achkoe/pt1000thermometer/Readme.md

See doc/pt1000thermometer.pdf for some description of this project.
