achkoe/pt1000thermometer/doc/pt1000thermometer.pdf

## Thermometer with PT1000

# ~{RESET} 28 ~{RESET}3 VIN ³⁰ GND

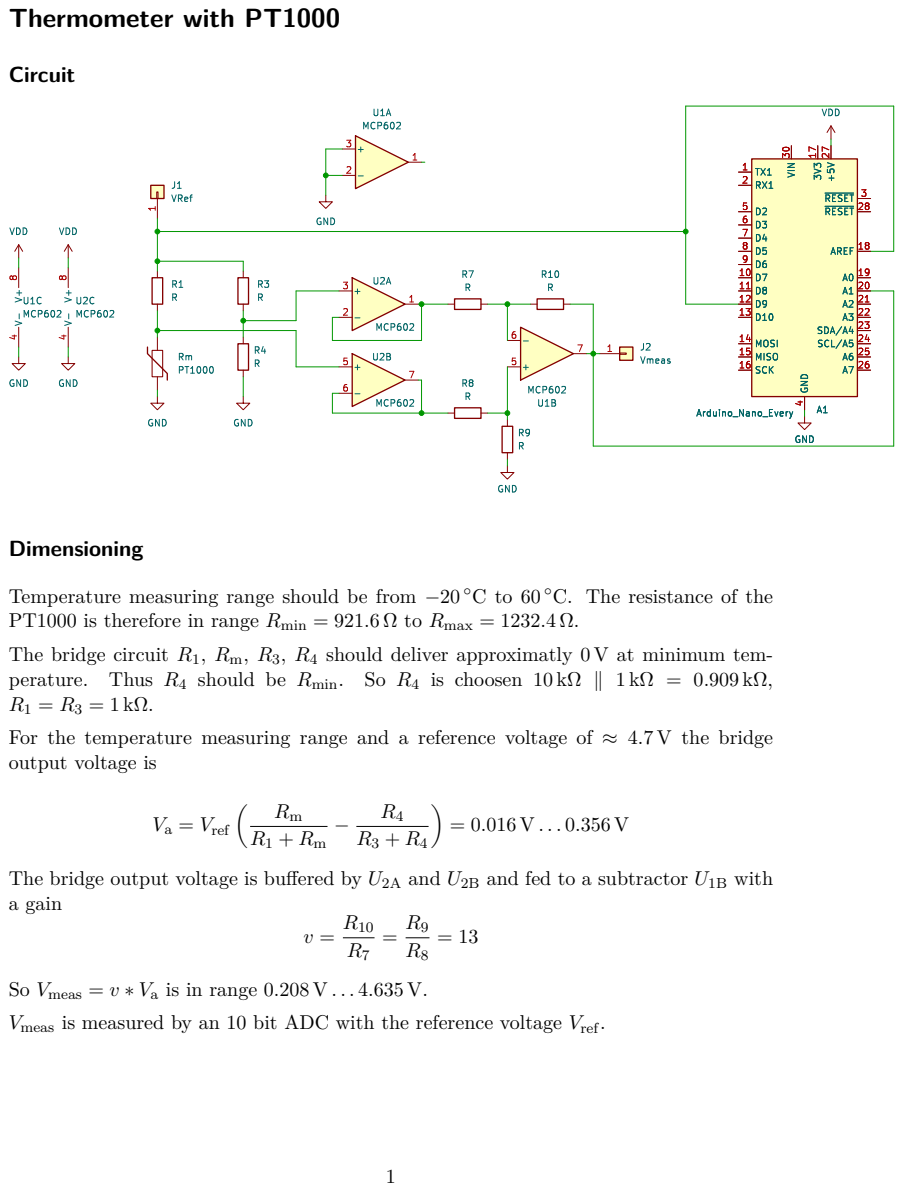
[picture p1: page 1]

Temperature measuring range should be from −20 ◦C to 60 ◦C. The resistance of the
PT1000 is therefore in range Rmin = 921.6 Ω to Rmax = 1232.4 Ω.
The bridge circuit R1, Rm, R3, R4 should deliver approximatly 0 V at minimum tem-
perature. Thus R4 should be Rmin. So R4 is choosen 10 kΩ ∥ 1 kΩ = 0.909 kΩ,
For the temperature measuring range and a reference voltage of ≈ 4.7 V the bridge
output voltage is

The bridge output voltage is buffered by U2A and U2B and fed to a subtractor U1B with
a gain

So Vmeas = v ∗ Va is in range 0.208 V . . . 4.635 V.
Vmeas is measured by an 10 bit ADC with the reference voltage Vref.

Relationship of temperature and ADC value

In the temperature measuring range the value of PT1000 resistor could be approximated
[1] by

Rm = R0(1 + AT + BT²
)

with R0 = 1000 Ω, A = 3.9083 · 10−3 1 ◦C

and B = −5.7750 · 10−7 1
◦C² within the accuracy
of the ADC.
Vice versa the temperature could be calculated with

T1,2 = −

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
The value of PT1000 resistor is calculated

Va =

Vmeas
v

+ Vref

R4
R3 + R4

Rm = R1

Va

Vref − Va

The Vmeas could be determined from ADC value D by

Vmeas =

DVref
2

10

Simplification

Vmeas = D

Vref
1024

(1)

Va =

Vmeas
v
+ kVref | with | k =

R4
R3 + R4

(2)

= D

Vref
1024v
+ kVref | (3)
Rm | = R1

Va

Vref − Va

(4)

= R1

D

Vref
1024v + kVref

Vref −

(
D

Vref

1024v + kVref) = R1

D
1024v + k

1 −

(
D
1024v + k
) | (5)

= R1

D + 1024vk
1024v (1 − k) − D

(6)

Note, the value of Rm does not depend on Vref!

2

Measuring

The measurement of the temperature is done as follows
- drive the output D9, which actually supplies Vref, to high
- wait 10 ms
- measure voltage
- drive the output to low
- wait 2 s to let the PT1000 cool down

## References

[1] Application Note, A Basic Guide to RTD Measurements. https://www.ti.com/lit/an/sbaa275a/sbaa275a.pdf. Retrieved 2024-01-07

3
