achkoe/pt1000thermometer/doc/pt1000thermometer.tex

\documentclass[fontsize=11pt, oneside]{scrartcl}
%\usepackage[textwidth=10cm, lmargin=4cm, rmargin=3cm ]{geometry}
\usepackage{hyperref}
\hypersetup{colorlinks, linkcolor=black, citecolor=blue, urlcolor=black}
\usepackage[utf8]{inputenc}
\usepackage[english]{babel}
\usepackage{siunitx}
\usepackage{graphicx}
\usepackage{supertabular}
\graphicspath{{../schematics/}}

\parindent0pt
\parskip1ex

\newcommand{\F}[2]{{#1}_\mathrm{#2}}

\begin{document}

\section*{Thermometer with PT1000}

\subsection*{Circuit}


\subsection*{Dimensioning}

Temperature measuring range should be from $\qty{-20}{\degreeCelsius}$ to $\qty{+60}{\degreeCelsius}$.
The resistance of the PT1000 is therefore in range
$\F{R}{min} = \qty{921.6}{\ohm}$ to $\F{R}{max} = \qty{1232.4}{\ohm}$.

The bridge circuit $\F{R}{1}$, $\F{R}{m}$, $\F{R}{3}$, $\F{R}{4}$ should deliver approximatly $\qty{0}{\volt}$ at minimum
temperature. Thus $\F{R}{4}$ should be $\F{R}{min}$.
So $\F{R}{4}$ is choosen $\qty{10}{k\ohm} \parallel \qty{1}{k\ohm} = \qty{0.909}{k\ohm}$,
$\F{R}{1} = \F{R}{3} = \qty{1}{k\ohm}$.

For the temperature measuring range
and a reference voltage of $\approx\qty{4.7}{\volt}$
the bridge output voltage is

$$
\F{V}{a} = \F{V}{ref} \left( \frac{\F{R}{m}}{\F{R}{1} + \F{R}{m}} - \frac{\F{R}{4}}{\F{R}{3} + \F{R}{4}}\right) = \qty{0.016}{\volt} \ldots \qty{0.356}{\volt}
$$
%    Um = Ue * Rm / (R1 + Rm)
%    U4 = Ue * R4 / (R3 + R4)
%    Ua = V * (Um - U4)

The bridge output voltage is buffered by $\F{U}{2A}$ and $\F{U}{2B}$ and fed to a subtractor $\F{U}{1B}$
with a gain
$$
v = \frac{\F{R}{10}} {\F{R}{7}} = \frac{\F{R}{9}} {\F{R}{8}} = 13
$$

So $\F{V}{meas} = v * \F{V}{a}$ is in range $\qty{0.208}{\volt} \ldots \qty{4.635}{\volt}$.

$\F{V}{meas}$ is measured by an 10 bit ADC with the reference voltage $\F{V}{ref}$.

\subsection*{Relationship of temperature and ADC value}

In the temperature measuring range the value of PT1000 resistor could be approximated
\cite{la} by

$$
\F{R}{m} = \F{R}{0} (1 + A T + B T^2)
$$

with $\F{R}{0} = \qty{1000}{\ohm}, $ $A=3.9083\cdot 10^{-3}\frac{1}{\unit{\degreeCelsius}}$ and $B=-5.7750\cdot10^{-7}\frac{1}{\unit{\degreeCelsius}^2}$
within the accuracy of the ADC.

Vice versa the temperature could be calculated with

$$
\F{T}{1,2} = -\frac{A}{2B} \sqrt{\left(\frac{A}{2B}\right)^2 - \frac{1}{B}\left(1 - \frac{\F{R}{m}}{\F{R}{0}} \right)}
$$

The value of PT1000 resistor is calculated
$$
\F{V}{a} = \frac{\F{V}{meas}}{v} + \F{V}{ref} \frac{\F{R}{4}}{\F{R}{3} + \F{R}{4}}
$$
$$
\F{R}{m} = \F{R}{1} \frac{\F{V}{a}}{\F{V}{ref} - \F{V}{a}}
$$

The $\F{V}{meas}$ could be determined from ADC value $D$ by
$$
\F{V}{meas} = \frac{D \F{V}{ref}}{2^{10}}
$$

\subsection*{Simplification}
\begin{eqnarray}
    \F{V}{meas} &=& D \frac{\F{V}{ref}}{1024} \\
    \F{V}{a} &=& \frac{\F{V}{meas}}{v} + k\F{V}{ref} \qquad \mbox{with} \qquad k = \frac{\F{R}{4}}{\F{R}{3} + \F{R}{4}} \\
             &=& D \frac{\F{V}{ref}}{1024 v} + k\F{V}{ref} \\
    \F{R}{m} &=& \F{R}{1} \frac{\F{V}{a}} {\F{V}{ref} - \F{V}{a}} \\
             &=& \F{R}{1} \frac{D \frac{\F{V}{ref}}{1024 v} + k\F{V}{ref}}{\F{V}{ref} - \left(D \frac{\F{V}{ref}}{1024 v} + k\F{V}{ref}\right)} %
              =  \F{R}{1} \frac{\frac{D}{1024 v} + k}{1 - \left(\frac{D}{1024 v} + k\right)} \\
             &=&  \F{R}{1} \frac{D + 1024vk}{1024v\left(1-k\right) - D}
\end{eqnarray}
Note, the value of $\F{R}{m}$ does not depend on $\F{V}{ref}$!
        %Vmeas = value * Vref / 1024;
        %Va = Vmeas / v + Vref * R4 / (R3 + R4);

\subsection*{Measuring}

The measurement of the temperature is done as follows
\begin{itemize}
\item drive the output D9, which actually supplies $\F{V}{ref}$, to high
\item wait $\qty{10}{\milli\second}$
\item measure voltage
\item drive the output to low
\item wait $\qty{2}{\second}$ to let the PT1000 cool down
\end{itemize}

\begin{thebibliography}{}
\bibitem{la} Application Note, A Basic Guide to RTD Measurements. \\
https://www.ti.com/lit/an/sbaa275a/sbaa275a.pdf. Retrieved 2024-01-07
\end{thebibliography}

\end{document}

\clearpage

\subsection*{Appendix}

\tablecaption{ADC value and temperature}
\tablehead{\hline}
\tabletail{\hline}
% \begin{supertabular}{llllllllllllllll}
\begin{supertabular}{lrrrrrrrr}
D                         &      0 &      1 &      2 &      3 &      4 &      5 &      6 &      7 \\
T/$\unit{\degreeCelsius}$ & -23.18 & -23.11 & -23.04 & -22.97 & -22.90 & -22.83 & -22.76 & -22.69 \\
D                         &      8 &      9 &     10 &     11 &     12 &     13 &     14 &     15 \\
T/$\unit{\degreeCelsius}$ & -22.62 & -22.55 & -22.48 & -22.41 & -22.34 & -22.27 & -22.20 & -22.14 \\
D                         &     16 &     17 &     18 &     19 &     20 &     21 &     22 &     23 \\
T/$\unit{\degreeCelsius}$ & -22.07 & -22.00 & -21.93 & -21.86 & -21.79 & -21.72 & -21.65 & -21.58 \\
D                         &     24 &     25 &     26 &     27 &     28 &     29 &     30 &     31 \\
T/$\unit{\degreeCelsius}$ & -21.51 & -21.44 & -21.36 & -21.29 & -21.22 & -21.15 & -21.08 & -21.01 \\
D                         &     32 &     33 &     34 &     35 &     36 &     37 &     38 &     39 \\
T/$\unit{\degreeCelsius}$ & -20.94 & -20.87 & -20.80 & -20.73 & -20.66 & -20.59 & -20.52 & -20.45 \\
D                         &     40 &     41 &     42 &     43 &     44 &     45 &     46 &     47 \\
T/$\unit{\degreeCelsius}$ & -20.38 & -20.31 & -20.24 & -20.17 & -20.10 & -20.03 & -19.96 & -19.89 \\
D                         &     48 &     49 &     50 &     51 &     52 &     53 &     54 &     55 \\
T/$\unit{\degreeCelsius}$ & -19.82 & -19.75 & -19.68 & -19.60 & -19.53 & -19.46 & -19.39 & -19.32 \\
D                         &     56 &     57 &     58 &     59 &     60 &     61 &     62 &     63 \\
T/$\unit{\degreeCelsius}$ & -19.25 & -19.18 & -19.11 & -19.04 & -18.97 & -18.90 & -18.83 & -18.76 \\
D                         &     64 &     65 &     66 &     67 &     68 &     69 &     70 &     71 \\
T/$\unit{\degreeCelsius}$ & -18.68 & -18.61 & -18.54 & -18.47 & -18.40 & -18.33 & -18.26 & -18.19 \\
D                         &     72 &     73 &     74 &     75 &     76 &     77 &     78 &     79 \\
T/$\unit{\degreeCelsius}$ & -18.12 & -18.04 & -17.97 & -17.90 & -17.83 & -17.76 & -17.69 & -17.62 \\
D                         &     80 &     81 &     82 &     83 &     84 &     85 &     86 &     87 \\
T/$\unit{\degreeCelsius}$ & -17.55 & -17.47 & -17.40 & -17.33 & -17.26 & -17.19 & -17.12 & -17.05 \\
D                         &     88 &     89 &     90 &     91 &     92 &     93 &     94 &     95 \\
T/$\unit{\degreeCelsius}$ & -16.97 & -16.90 & -16.83 & -16.76 & -16.69 & -16.62 & -16.55 & -16.47 \\
D                         &     96 &     97 &     98 &     99 &    100 &    101 &    102 &    103 \\
T/$\unit{\degreeCelsius}$ & -16.40 & -16.33 & -16.26 & -16.19 & -16.11 & -16.04 & -15.97 & -15.90 \\
D                         &    104 &    105 &    106 &    107 &    108 &    109 &    110 &    111 \\
T/$\unit{\degreeCelsius}$ & -15.83 & -15.76 & -15.68 & -15.61 & -15.54 & -15.47 & -15.40 & -15.32 \\
D                         &    112 &    113 &    114 &    115 &    116 &    117 &    118 &    119 \\
T/$\unit{\degreeCelsius}$ & -15.25 & -15.18 & -15.11 & -15.04 & -14.96 & -14.89 & -14.82 & -14.75 \\
D                         &    120 &    121 &    122 &    123 &    124 &    125 &    126 &    127 \\
T/$\unit{\degreeCelsius}$ & -14.68 & -14.60 & -14.53 & -14.46 & -14.39 & -14.31 & -14.24 & -14.17 \\
D                         &    128 &    129 &    130 &    131 &    132 &    133 &    134 &    135 \\
T/$\unit{\degreeCelsius}$ & -14.10 & -14.02 & -13.95 & -13.88 & -13.81 & -13.73 & -13.66 & -13.59 \\
D                         &    136 &    137 &    138 &    139 &    140 &    141 &    142 &    143 \\
T/$\unit{\degreeCelsius}$ & -13.52 & -13.44 & -13.37 & -13.30 & -13.23 & -13.15 & -13.08 & -13.01 \\
D                         &    144 &    145 &    146 &    147 &    148 &    149 &    150 &    151 \\
T/$\unit{\degreeCelsius}$ & -12.94 & -12.86 & -12.79 & -12.72 & -12.64 & -12.57 & -12.50 & -12.43 \\
D                         &    152 &    153 &    154 &    155 &    156 &    157 &    158 &    159 \\
T/$\unit{\degreeCelsius}$ & -12.35 & -12.28 & -12.21 & -12.13 & -12.06 & -11.99 & -11.91 & -11.84 \\
D                         &    160 &    161 &    162 &    163 &    164 &    165 &    166 &    167 \\
T/$\unit{\degreeCelsius}$ & -11.77 & -11.70 & -11.62 & -11.55 & -11.48 & -11.40 & -11.33 & -11.26 \\
D                         &    168 &    169 &    170 &    171 &    172 &    173 &    174 &    175 \\
T/$\unit{\degreeCelsius}$ & -11.18 & -11.11 & -11.04 & -10.96 & -10.89 & -10.82 & -10.74 & -10.67 \\
D                         &    176 &    177 &    178 &    179 &    180 &    181 &    182 &    183 \\
T/$\unit{\degreeCelsius}$ & -10.60 & -10.52 & -10.45 & -10.37 & -10.30 & -10.23 & -10.15 & -10.08 \\
D                         &    184 &    185 &    186 &    187 &    188 &    189 &    190 &    191 \\
T/$\unit{\degreeCelsius}$ & -10.01 &  -9.93 &  -9.86 &  -9.79 &  -9.71 &  -9.64 &  -9.56 &  -9.49 \\
D                         &    192 &    193 &    194 &    195 &    196 &    197 &    198 &    199 \\
T/$\unit{\degreeCelsius}$ &  -9.42 &  -9.34 &  -9.27 &  -9.19 &  -9.12 &  -9.05 &  -8.97 &  -8.90 \\
D                         &    200 &    201 &    202 &    203 &    204 &    205 &    206 &    207 \\
T/$\unit{\degreeCelsius}$ &  -8.82 &  -8.75 &  -8.68 &  -8.60 &  -8.53 &  -8.45 &  -8.38 &  -8.31 \\
D                         &    208 &    209 &    210 &    211 &    212 &    213 &    214 &    215 \\
T/$\unit{\degreeCelsius}$ &  -8.23 &  -8.16 &  -8.08 &  -8.01 &  -7.93 &  -7.86 &  -7.79 &  -7.71 \\
D                         &    216 &    217 &    218 &    219 &    220 &    221 &    222 &    223 \\
T/$\unit{\degreeCelsius}$ &  -7.64 &  -7.56 &  -7.49 &  -7.41 &  -7.34 &  -7.26 &  -7.19 &  -7.12 \\
D                         &    224 &    225 &    226 &    227 &    228 &    229 &    230 &    231 \\
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
D                         &    976 &    977 &    978 &    979 &    980 &    981 &    982 &    983 \\
T/$\unit{\degreeCelsius}$ &  56.71 &  56.81 &  56.91 &  57.00 &  57.10 &  57.20 &  57.29 &  57.39 \\
D                         &    984 &    985 &    986 &    987 &    988 &    989 &    990 &    991 \\
T/$\unit{\degreeCelsius}$ &  57.48 &  57.58 &  57.68 &  57.77 &  57.87 &  57.97 &  58.07 &  58.16 \\
D                         &    992 &    993 &    994 &    995 &    996 &    997 &    998 &    999 \\
T/$\unit{\degreeCelsius}$ &  58.26 &  58.36 &  58.45 &  58.55 &  58.65 &  58.74 &  58.84 &  58.94 \\
D                         &   1000 &   1001 &   1002 &   1003 &   1004 &   1005 &   1006 &   1007 \\
T/$\unit{\degreeCelsius}$ &  59.03 &  59.13 &  59.23 &  59.33 &  59.42 &  59.52 &  59.62 &  59.72 \\
D                         &   1008 &   1009 &   1010 &   1011 &   1012 &   1013 &   1014 &   1015 \\
T/$\unit{\degreeCelsius}$ &  59.81 &  59.91 &  60.01 &  60.11 &  60.20 &  60.30 &  60.40 &  60.50 \\
D                         &   1016 &   1017 &   1018 &   1019 &   1020 &   1021 &   1022 &   1023 \\
T/$\unit{\degreeCelsius}$ &  60.59 &  60.69 &  60.79 &  60.89 &  60.99 &  61.08 &  61.18 &  61.28 \\
\end{supertabular}

Vmeas = D * Vref / 1024
Rm = R1 * Va / (Vref - Va)
Va = Vmeas / v + Vref * k = D * Vref / (v * 1024) + Vref * k = Vref * (D / (v * 1024) + k)
k = R4 / (R3 + R4) = 10 || 1 / (10 || 1 + 1) 
R4 = 0.9090909090909091 kOhm
k = 0.47619047619047616

Rm = R1 * Vref * (D / (v * 1024) + k) / (Vref - Vref * (D / (v * 1024) + k))
   = Vref * R1 * (D / (v * 1024) + k) / (Vref * (1 - (D / (v * 1024) + k)))
   = R1 * x / (1 - x) mit x = D / (v * 1024) + k
   = R1 / (1 / x - 1)
