achkoe/pt1000thermometer/schematics/schematics.pdf

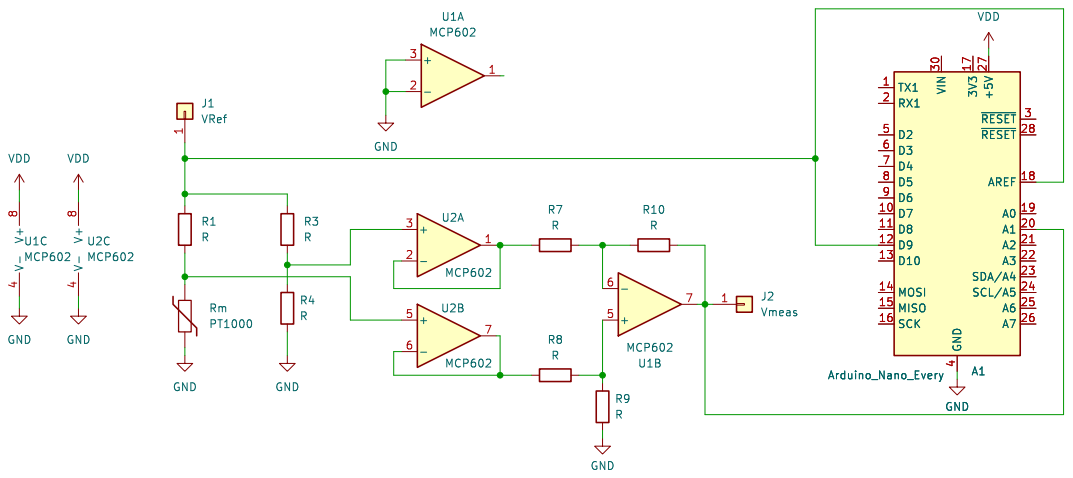
[picture p2: page 1]
