achkoe/pt1000thermometer/schematics/schematics.kicad_pcb

## KiCad design schematics/schematics.kicad_pcb (2024-01-28)

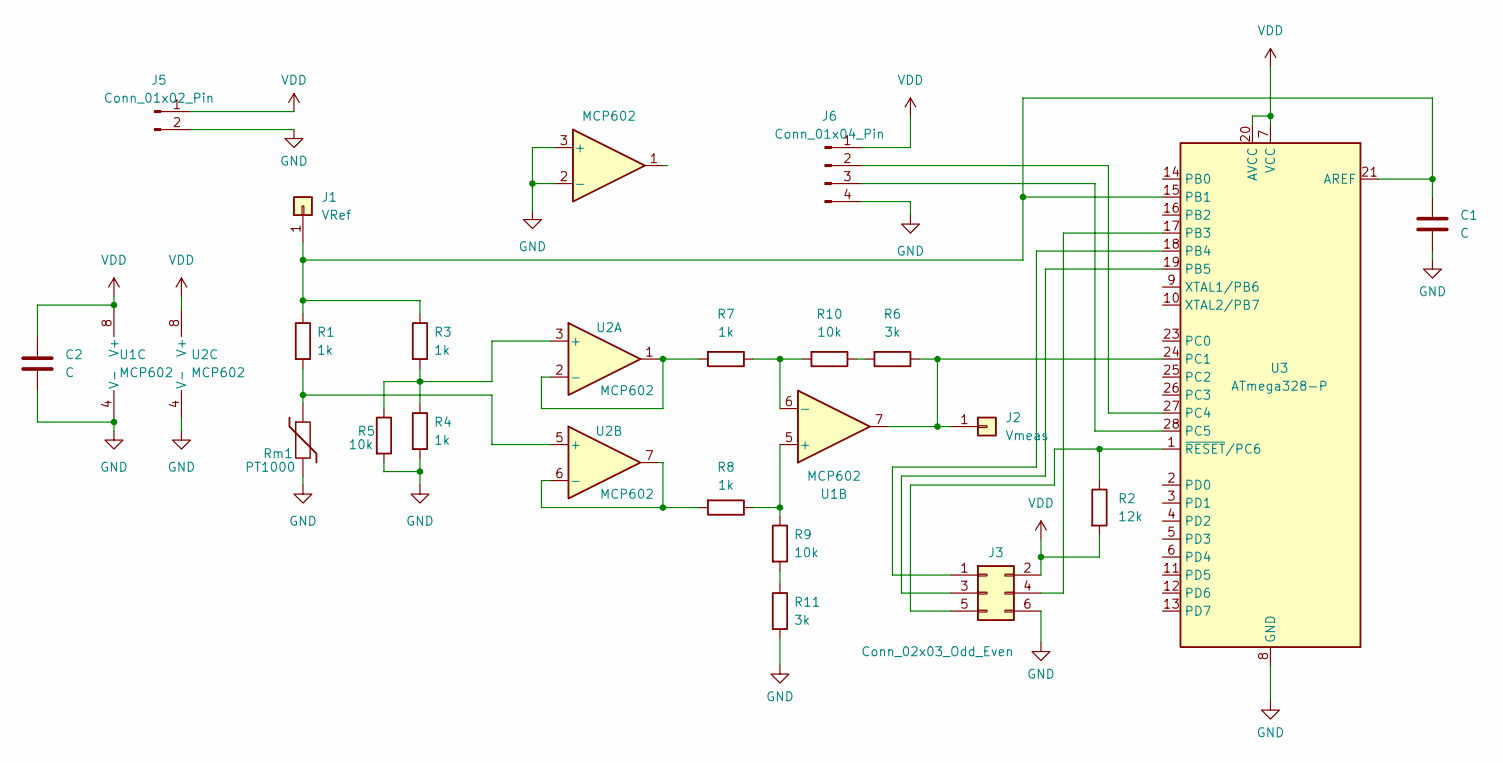
[picture p3: schematic schematics.kicad_sch]

Parts:
C1, C2: C; CP_Axial_L10.0mm_D4.5mm_P15.00mm_Horizontal
J1: VRef; Pin_D1.0mm_L10.0mm
J2: Vmeas; Pin_D1.0mm_L10.0mm
J3: Conn_02x03_Odd_Even; PinHeader_2x03_P2.54mm_Vertical
J5: Conn_01x02_Pin; PinHeader_1x02_P2.54mm_Vertical
J6: Conn_01x04_Pin; PinHeader_1x04_P2.54mm_Vertical
R1, R3, R4, R7, R8: 1k; R_Axial_DIN0207_L6.3mm_D2.5mm_P10.16mm_Horizontal
R2: 12k; R_Axial_DIN0207_L6.3mm_D2.5mm_P10.16mm_Horizontal
R5, R9, R10: 10k; R_Axial_DIN0207_L6.3mm_D2.5mm_P10.16mm_Horizontal
R6, R11: 3k; R_Axial_DIN0207_L6.3mm_D2.5mm_P10.16mm_Horizontal
Rm1: PT1000; R_Axial_DIN0204_L3.6mm_D1.6mm_P2.54mm_Vertical
U1, U2: MCP602; DIP-8_W7.62mm
U3: ATmega328-P; DIP-28_W7.62mm

Connections:
GND: C1.2, C2.2, J3.6, J5.2, J6.4, R4.2, R5.2, R11.2, Rm1.2, U1.2 (-), U1.3 (+), U1.4 (V-), U2.4 (V-), U3.8 (GND), U3.22 (GND)
unnamed: C1.1, J1.1, R1.1, R3.1, U3.15 (PB1), U3.21 (AREF)
unnamed: J2.1, R6.1, U1.7, U3.24 (PC1)
unnamed: J3.1, U3.18 (PB4)
unnamed: J3.3, U3.19 (PB5)
unnamed: J3.4, U3.17 (PB3)
unnamed: J3.5, R2.1, U3.1 (~RESET/PC6)
unnamed: J6.2, U3.27 (PC4)
unnamed: J6.3, U3.28 (PC5)
unnamed: R6.2, R10.1
unnamed: R9.2, R11.1
unnamed: R8.1, R9.1, U1.5 (+)
unnamed: R7.1, R10.2, U1.6 (-)
unnamed: R3.2, R4.1, R5.1, U2.3 (+)
unnamed: R7.2, U2.1, U2.2 (-)
unnamed: R1.2, Rm1.1, U2.5 (+)
unnamed: R8.2, U2.6 (-), U2.7
VDD: C2.1, J3.2, J5.1, J6.1, R2.2, U1.8 (V+), U2.8 (V+), U3.7 (VCC), U3.20 (AVCC)

Board: 2 copper layers, 22 parts (0 on the bottom side), 18 nets, no tracks yet.
